mattybabaallos/ACIS/Code/ACIS/TestImages/left.jpg

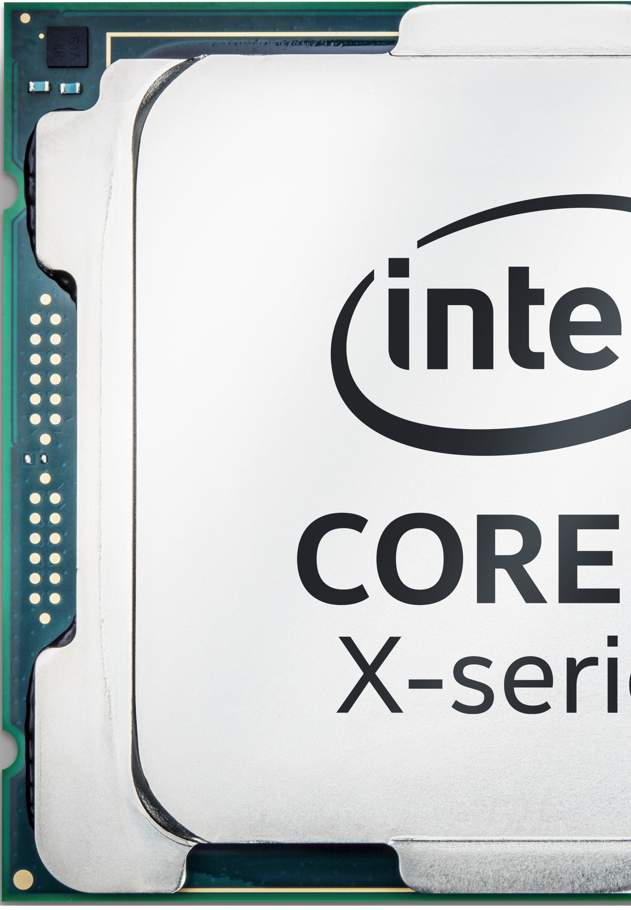
Code/ACIS/TestImages/left.jpg
