mattybabaallos/ACIS/Code/ACIS/TestImages/real1.jpg

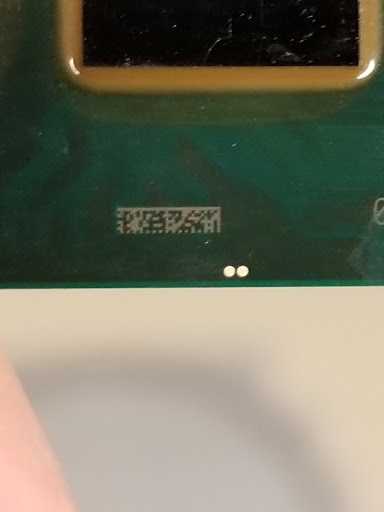
Code/ACIS/TestImages/real1.jpg
