mattybabaallos/ACIS/README.md

# ACIS
Automated Check-in Station

This repo is the home for the ACIS Portland State University ECE 2018 Capstone.
