mattybabaallos/ACIS/Documents/poster_diagram.pdf

Windows front end
Mechanical unit

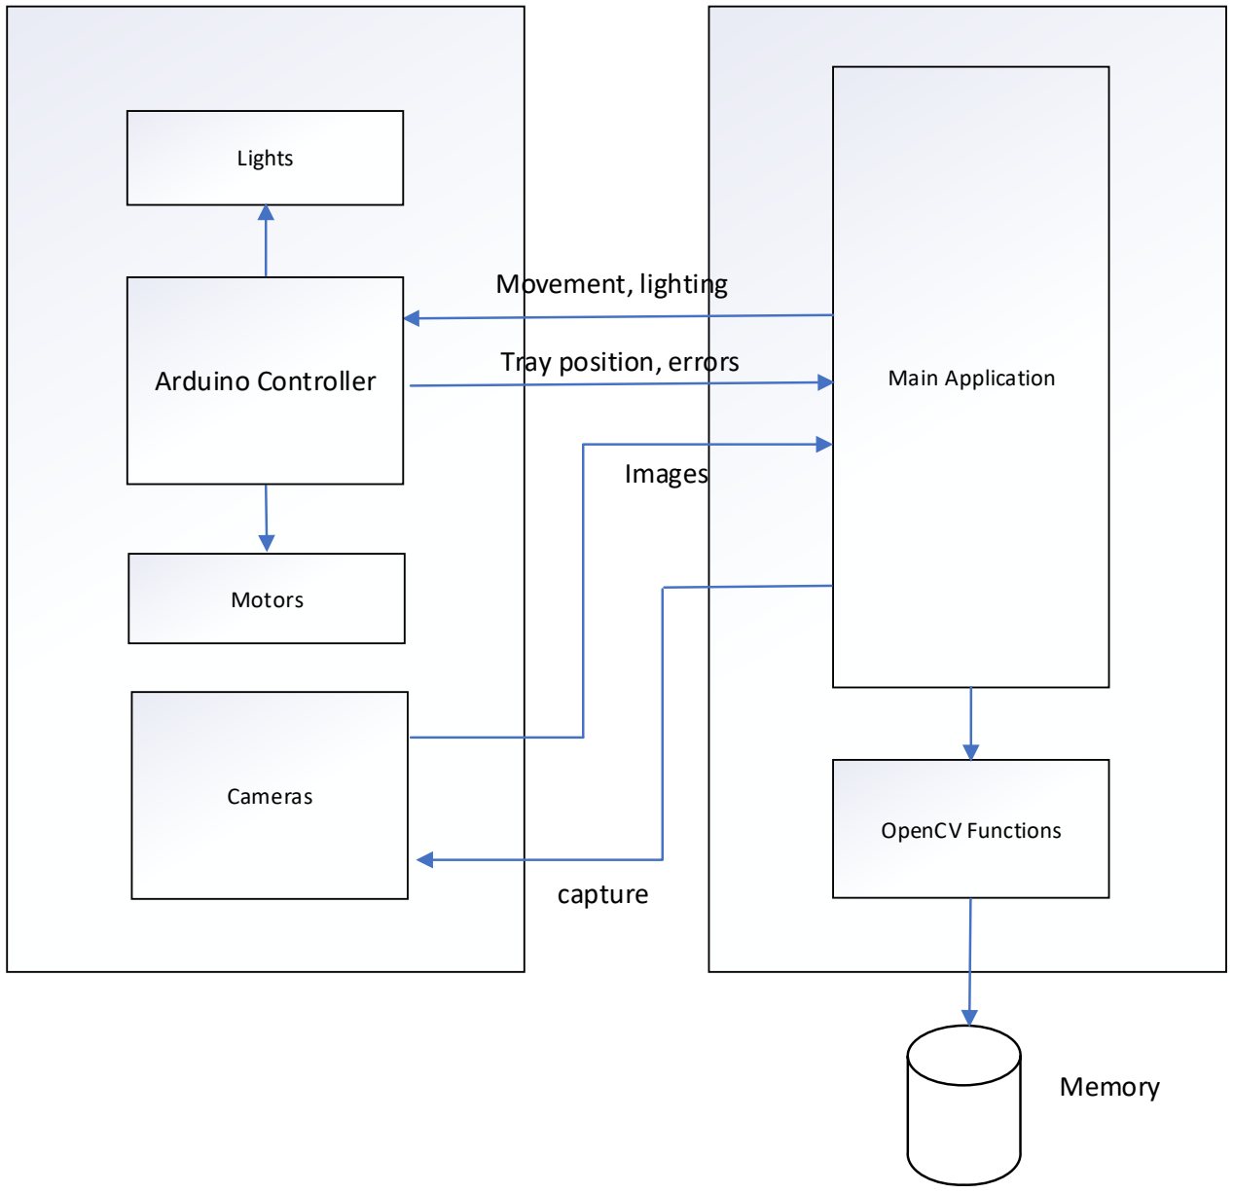
[picture p3: figure]
Main Application; OpenCV Functions; Cameras; Memory; Arduino Controller; Motors; Lights; Tray position, errors; Movement, lighting; Images; capture
