mattybabaallos/ACIS/Code/ACIS/CV/Resources/barcode3.jpg

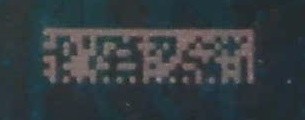
Code/ACIS/CV/Resources/barcode3.jpg
