mattybabaallos/ACIS/Code/ACIS/CV/Resources/barcode4.jpg

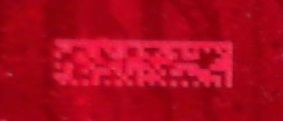
Code/ACIS/CV/Resources/barcode4.jpg
