mattybabaallos/ACIS/Code/ACIS/CV/Resources/Bot.jpg

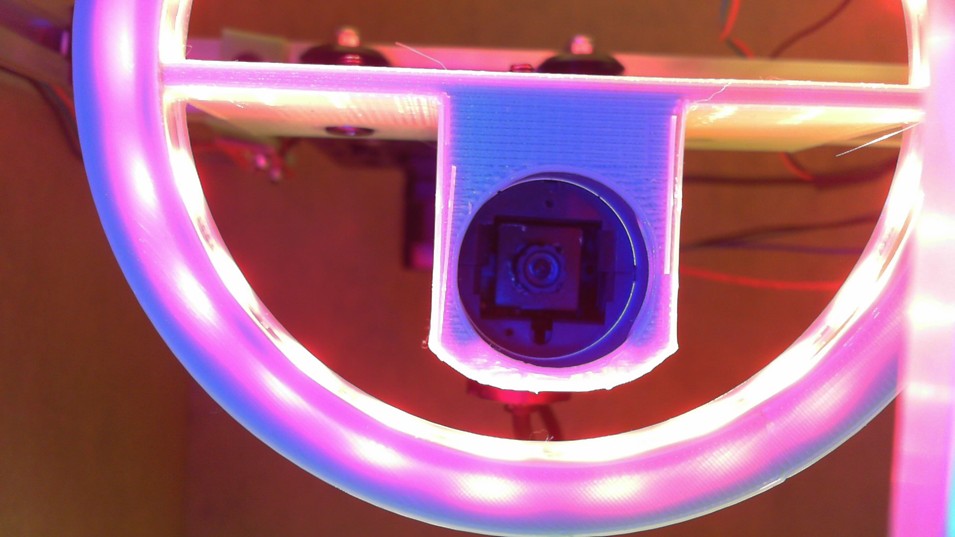
Code/ACIS/CV/Resources/Bot.jpg
