mattybabaallos/ACIS/Code/ACIS/CV/Resources/Bottom.jpg

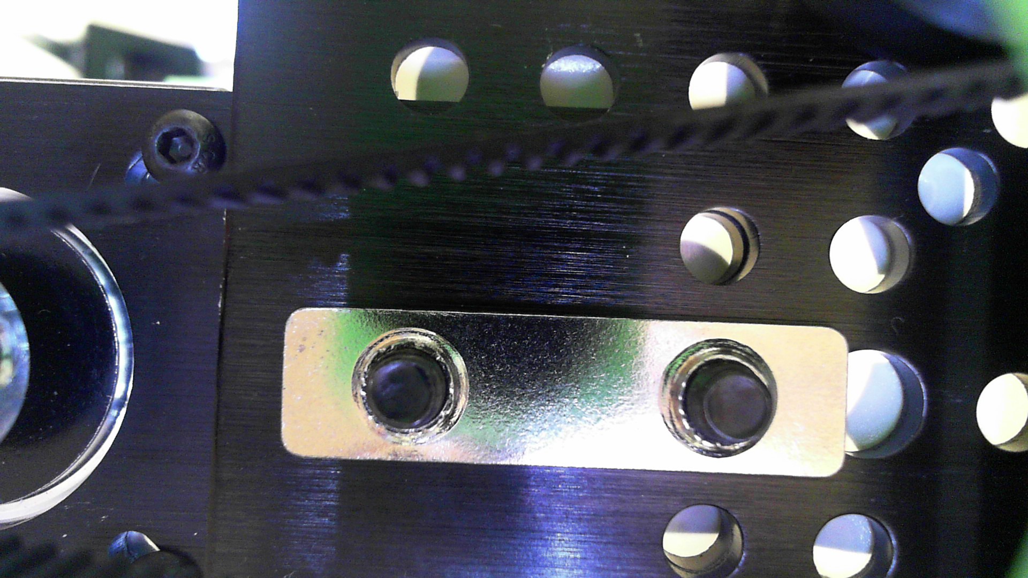
Code/ACIS/CV/Resources/Bottom.jpg
