mattybabaallos/ACIS/Code/ACIS/CV/Resources/Bottom_datamatrix.jpg

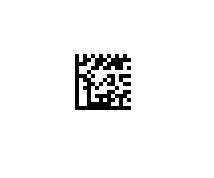
Code/ACIS/CV/Resources/Bottom_datamatrix.jpg
