mattybabaallos/ACIS/Code/ACIS/CV/Resources/Top.jpg

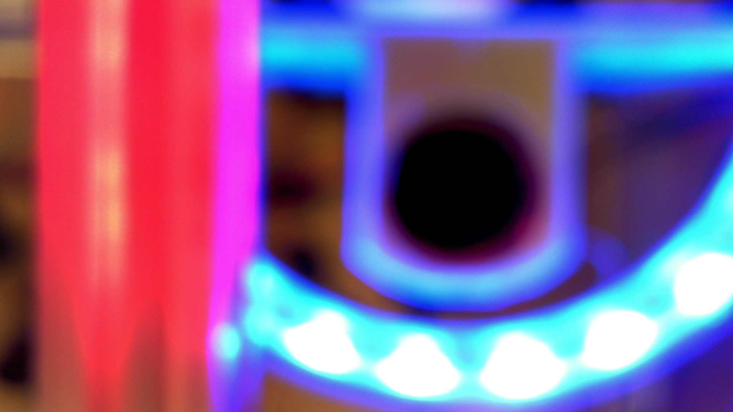
Code/ACIS/CV/Resources/Top.jpg
