mattybabaallos/ACIS/Code/ACIS/CV/Resources/Top_datamatrix.jpg

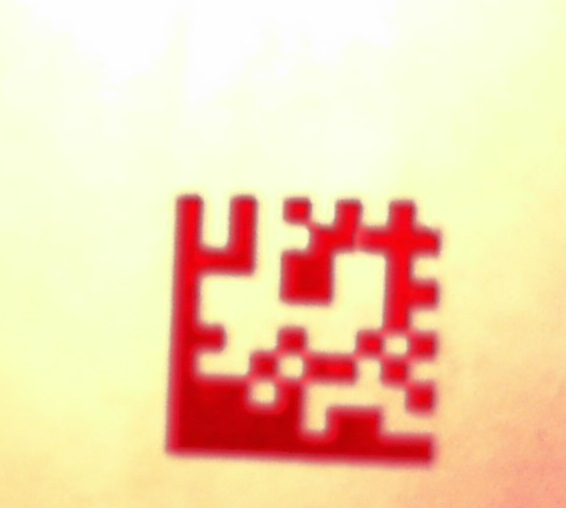
Code/ACIS/CV/Resources/Top_datamatrix.jpg
