mattybabaallos/ACIS/Documents/poster_diagram.png

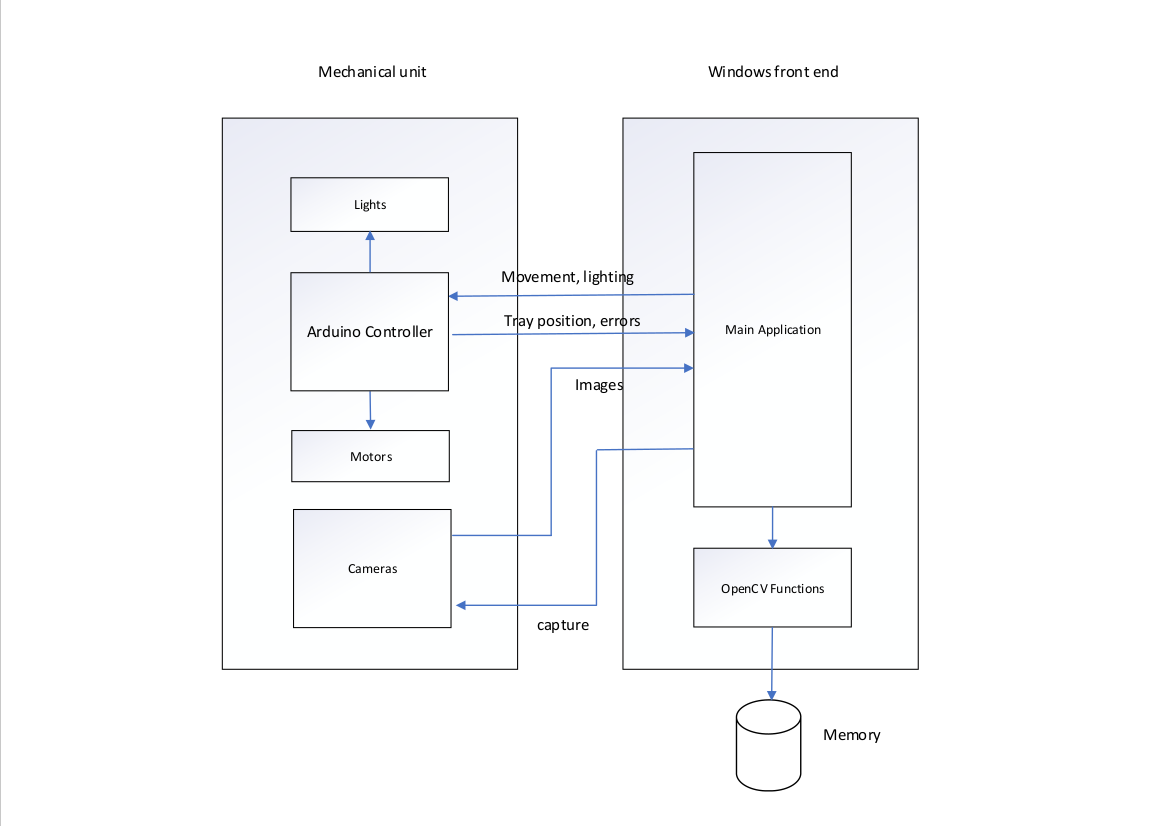
Documents/poster_diagram.png
