mattybabaallos/ACIS/Documents/3DModels/tray_assembly.SLDASM

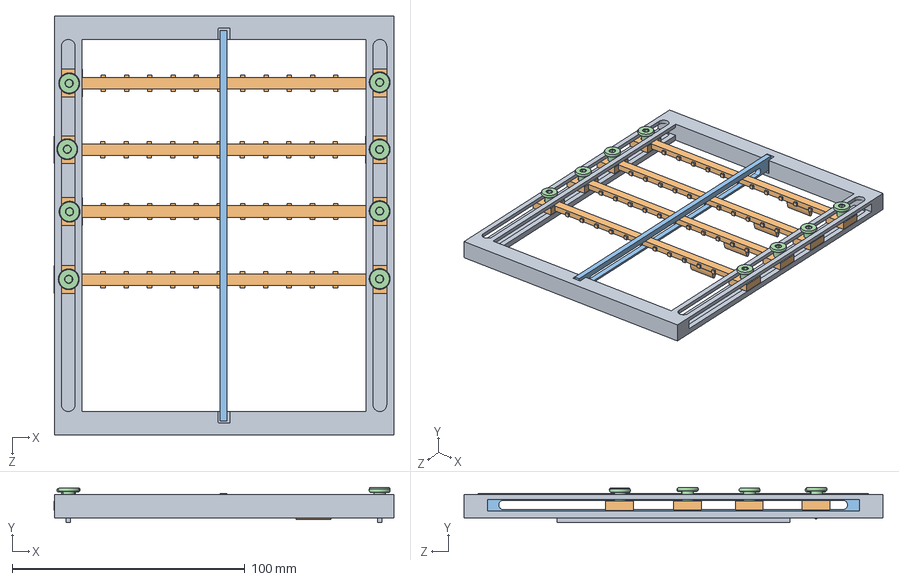
[picture p35: CAD file, 2018-04-30]
Documents/3DModels/tray_assembly.SLDASM
146.2 x 15.1 x 180.0 mm
main4
holder x 4
middlebar
Low Profile Screw M5 x 8
