mattybabaallos/ACIS/Documents/3DModels/main.STL

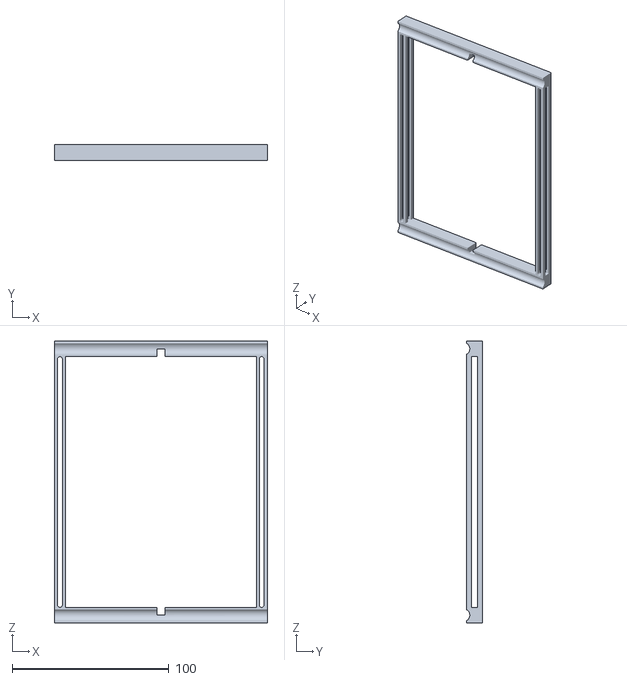
[picture p36: CAD file, 2018-04-12]
Documents/3DModels/main.STL
136.0 x 10.00 x 180.0
