mattybabaallos/ACIS/Documents/3DModels/smalltray.SLDPRT

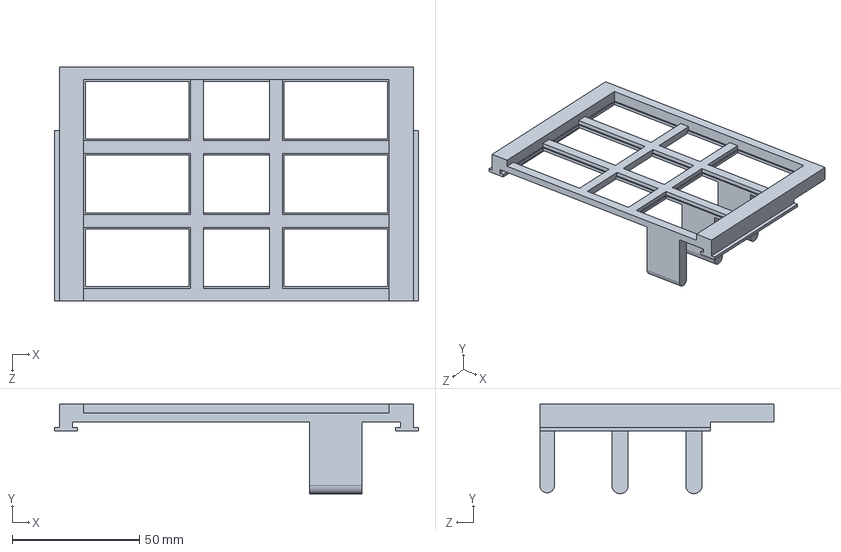
[picture p37: CAD file, 2018-04-30]
Documents/3DModels/smalltray.SLDPRT
143.0 x 35.2 x 92.0 mm
