mattybabaallos/ACIS/Documents/3DModels/STL Files/USB connector v31.stl

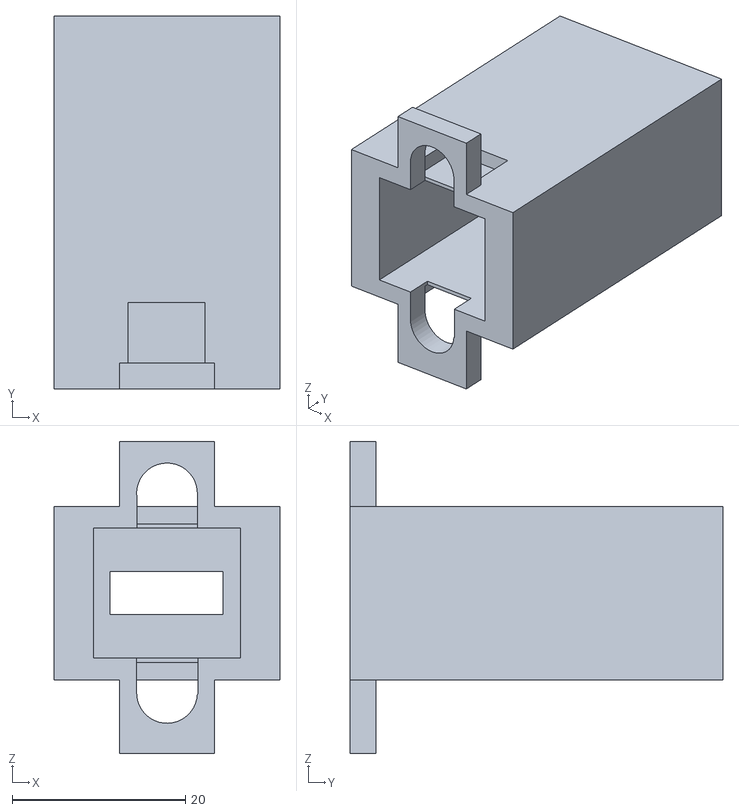
[picture p38: CAD file, 2018-06-16]
Documents/3DModels/STL Files/USB connector v31.stl
26.0 x 43.0 x 36.0
