mattybabaallos/ACIS/Documents/xdf/top 1.dxf

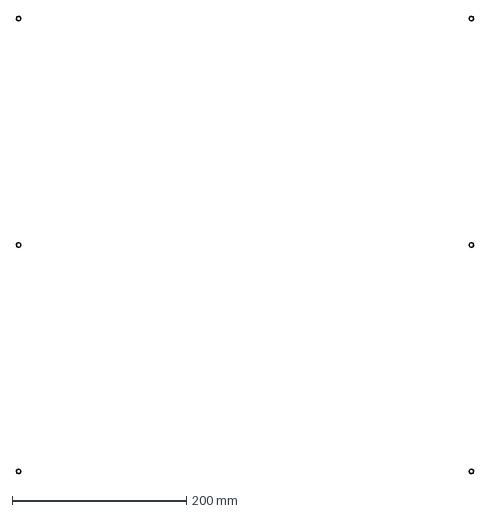
[picture p39: CAD file, 2018-05-24]
Documents/xdf/top 1.dxf
525.0 x 525.0 mm
