mattybabaallos/ACIS/Documents/3DModels/STL Files/camera lens v1.stl

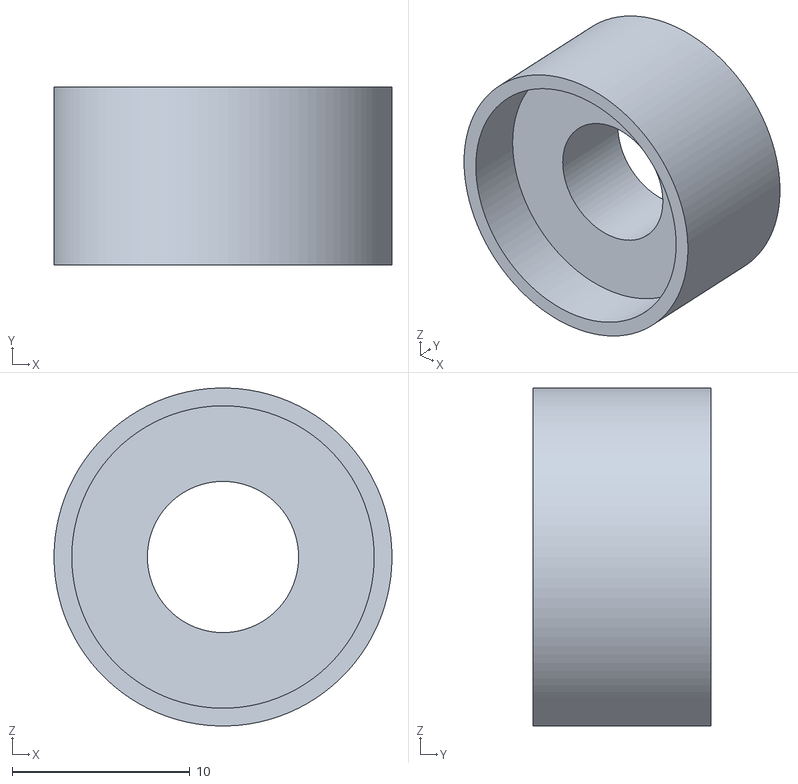
[picture p40: CAD file, 2018-06-16]
Documents/3DModels/STL Files/camera lens v1.stl
19.0 x 10.0 x 19.0
