mattybabaallos/ACIS/Documents/xdf/right.dxf

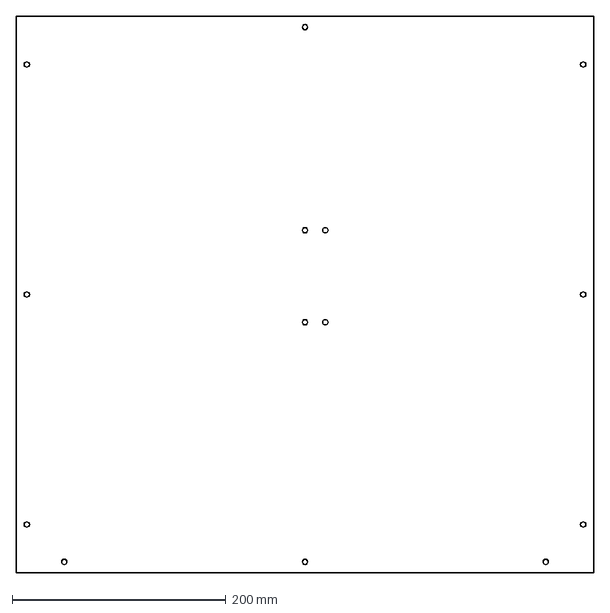
[picture p41: CAD file, 2018-05-24]
Documents/xdf/right.dxf
540.0 x 520.0 mm
