mattybabaallos/ACIS/Documents/3DModels/STL Files/Bottom camera v4.stl

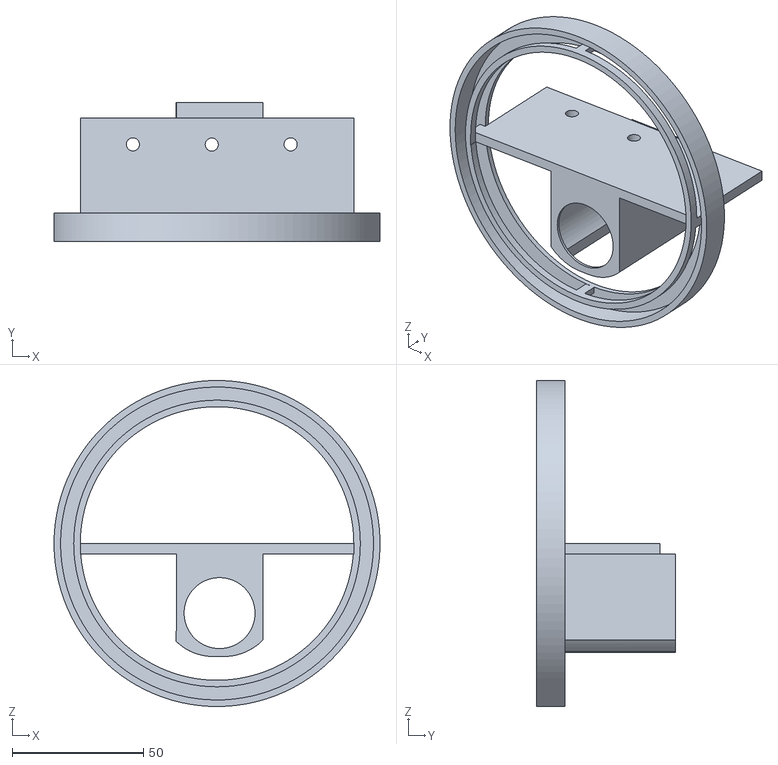
[picture p42: CAD file, 2018-06-16]
Documents/3DModels/STL Files/Bottom camera v4.stl
124.0 x 53.0 x 124.0
