mattybabaallos/ACIS/Documents/3DModels/x_button_holder.STL

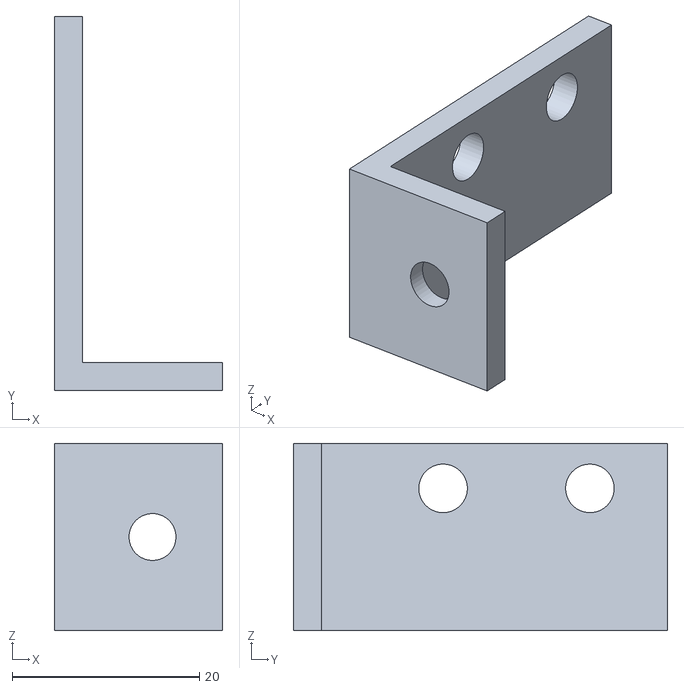
[picture p43: CAD file, 2018-04-30]
Documents/3DModels/x_button_holder.STL
18.0 x 40.0 x 20.0
