mattybabaallos/ACIS/Documents/xdf/back 2.dxf

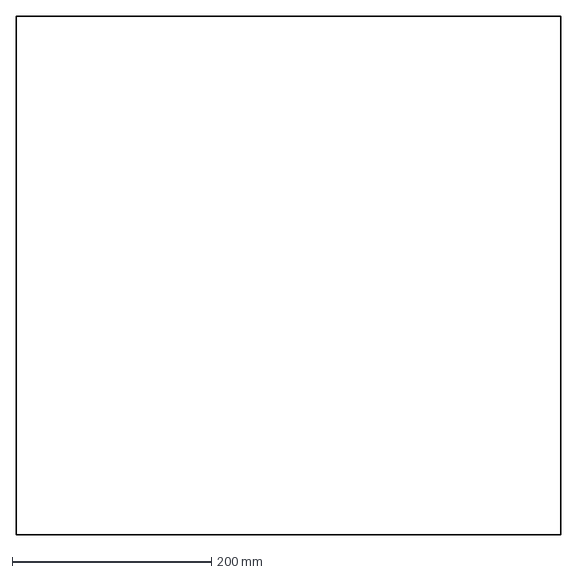
[picture p44: CAD file, 2018-05-24]
Documents/xdf/back 2.dxf
546.0 x 520.0 mm
