mattybabaallos/ACIS/Documents/3DModels/STL Files/Camera top v35.stl

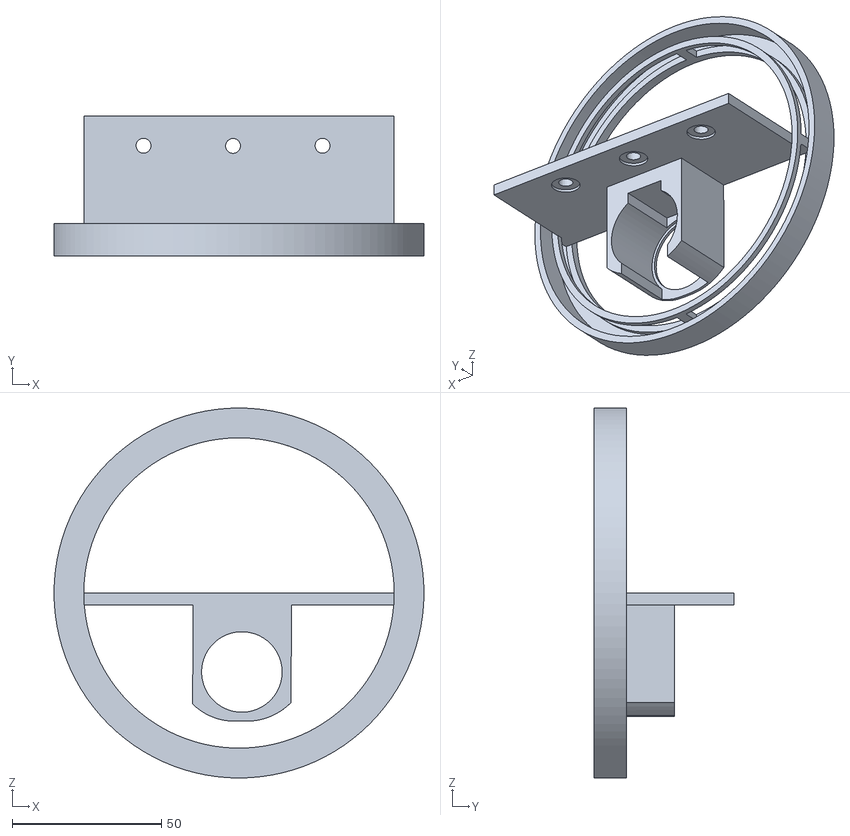
[picture p45: CAD file, 2018-06-16]
Documents/3DModels/STL Files/Camera top v35.stl
124.0 x 47.0 x 124.0
