mattybabaallos/ACIS/Documents/3DModels/x_button_top.STL

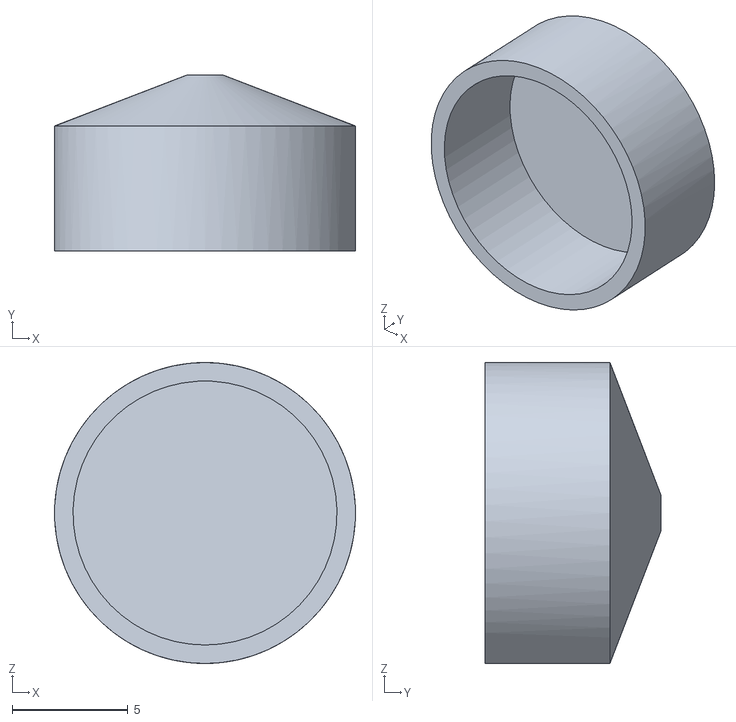
[picture p46: CAD file, 2018-04-30]
Documents/3DModels/x_button_top.STL
13.0 x 7.60 x 13.0
