mattybabaallos/ACIS/Documents/xdf/front 1.dxf

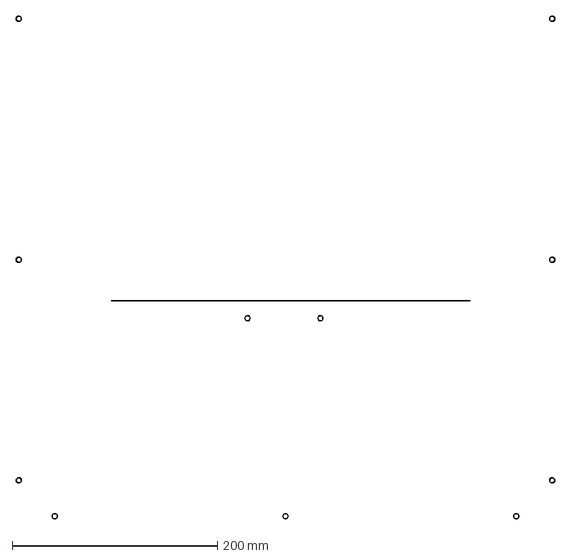
[picture p47: CAD file, 2018-05-24]
Documents/xdf/front 1.dxf
525.0 x 490.0 mm
