mattybabaallos/ACIS/Documents/3DModels/middlebar.STL

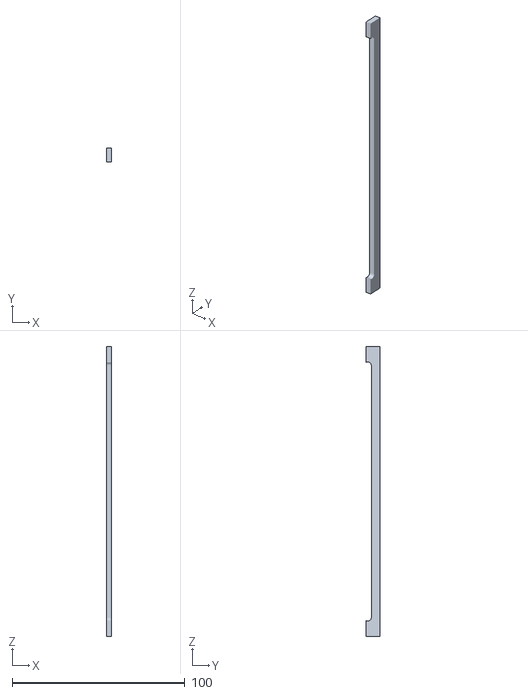
[picture p48: CAD file, 2018-04-30]
Documents/3DModels/middlebar.STL
3.00 x 8.00 x 168.0
