mattybabaallos/ACIS/Documents/3DModels/STL Files/SmallCamera holder v15.stl

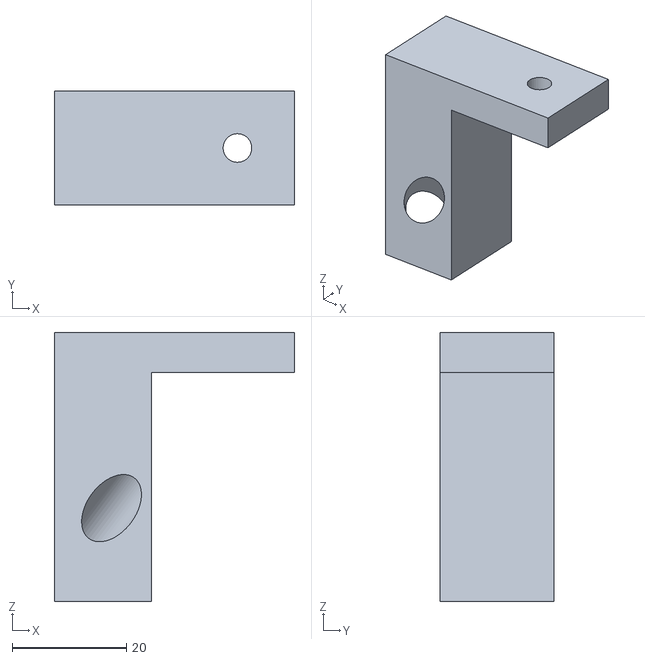
[picture p49: CAD file, 2018-06-14]
Documents/3DModels/STL Files/SmallCamera holder v15.stl
42.0 x 20.0 x 47.0
