mattybabaallos/ACIS/Documents/xdf/back 1.dxf

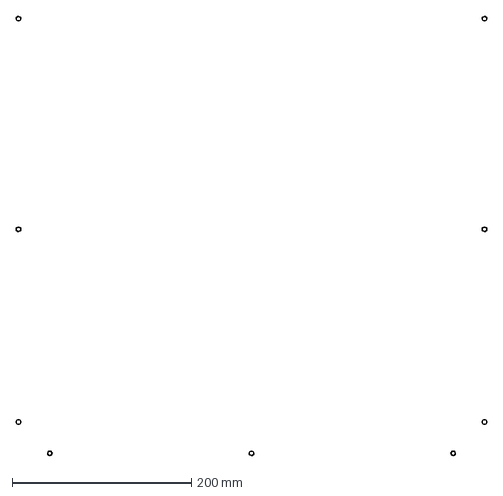
[picture p50: CAD file, 2018-05-24]
Documents/xdf/back 1.dxf
525.0 x 490.0 mm
