mattybabaallos/ACIS/Documents/3DModels/STL Files/PSU bracket_with_notch v6.stl

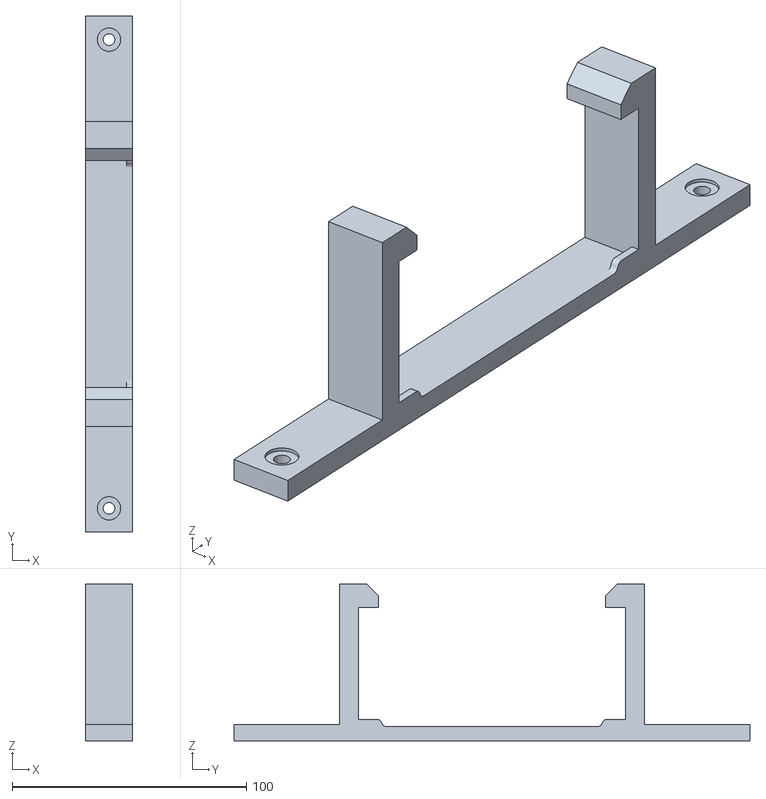
[picture p51: CAD file, 2018-05-22]
Documents/3DModels/STL Files/PSU bracket_with_notch v6.stl
20.0 x 220.0 x 67.0
