mattybabaallos/ACIS/Documents/xdf/front 2.dxf

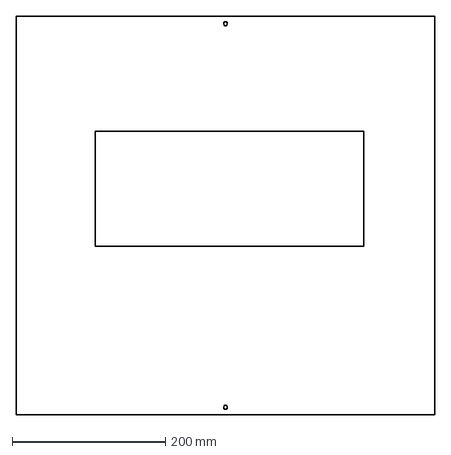
[picture p52: CAD file, 2018-05-24]
Documents/xdf/front 2.dxf
546.0 x 520.0 mm
