mattybabaallos/ACIS/Documents/3DModels/STL Files/PSU bracket_no_notch v8.stl

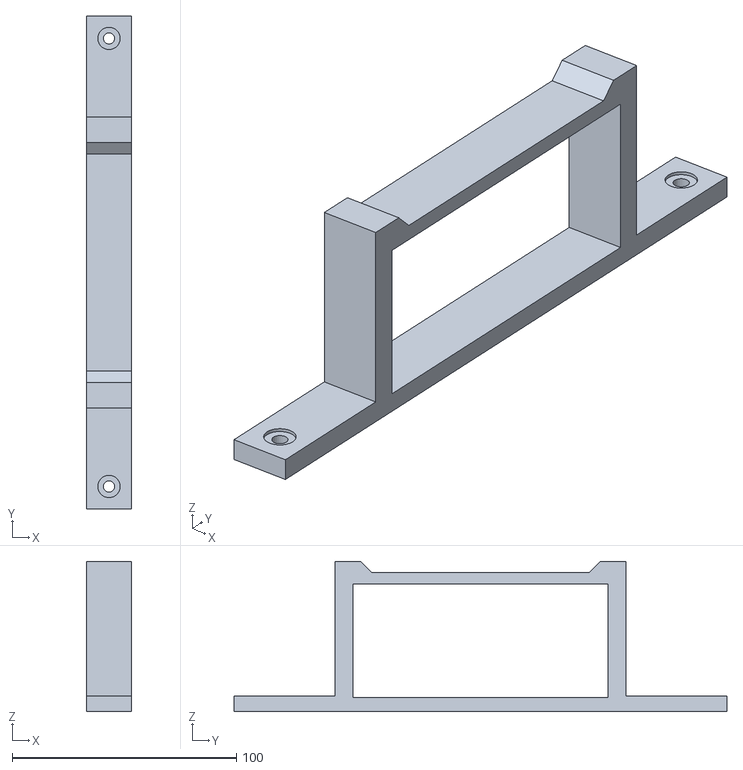
[picture p53: CAD file, 2018-05-22]
Documents/3DModels/STL Files/PSU bracket_no_notch v8.stl
20.0 x 220.0 x 67.0
