mattybabaallos/ACIS/Documents/xdf/bottom.dxf

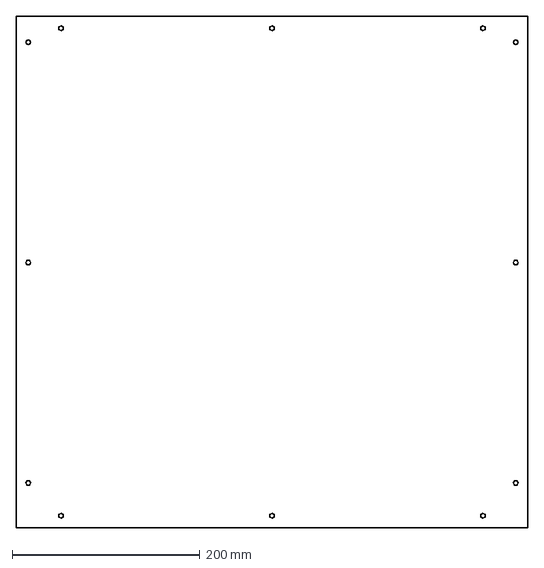
[picture p54: CAD file, 2018-05-24]
Documents/xdf/bottom.dxf
546.0 x 546.0 mm
