mattybabaallos/ACIS/Documents/3DModels/STL Files/Limit Switch v10.stl

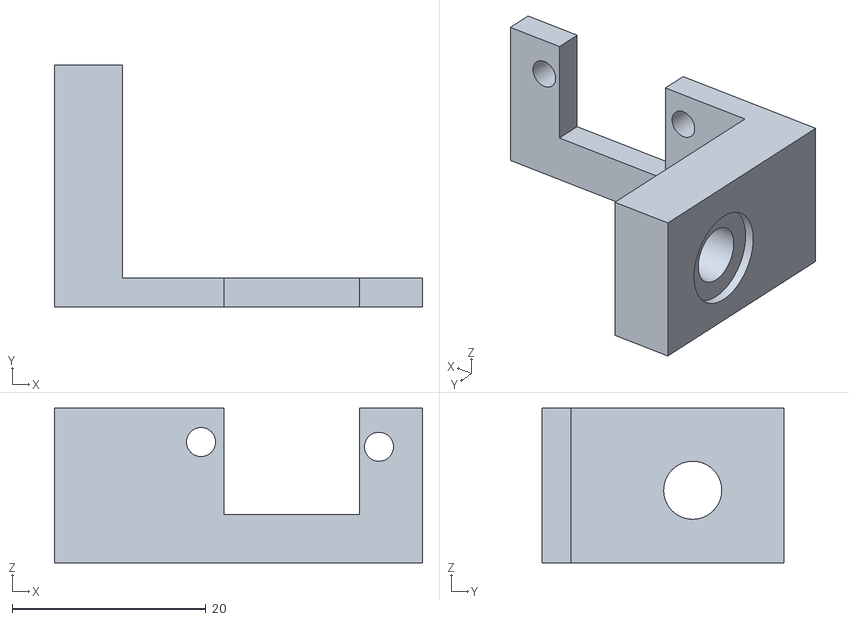
[picture p55: CAD file, 2018-05-18]
Documents/3DModels/STL Files/Limit Switch v10.stl
38.0 x 25.0 x 16.0
