mattybabaallos/ACIS/Documents/xdf/left.dxf

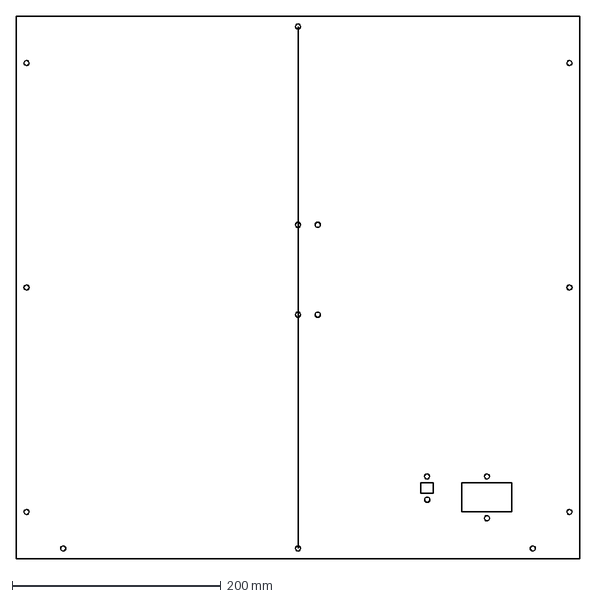
[picture p56: CAD file, 2018-05-24]
Documents/xdf/left.dxf
540.0 x 520.0 mm
