mattybabaallos/ACIS/Documents/3DModels/STL Files/Hub v28.stl

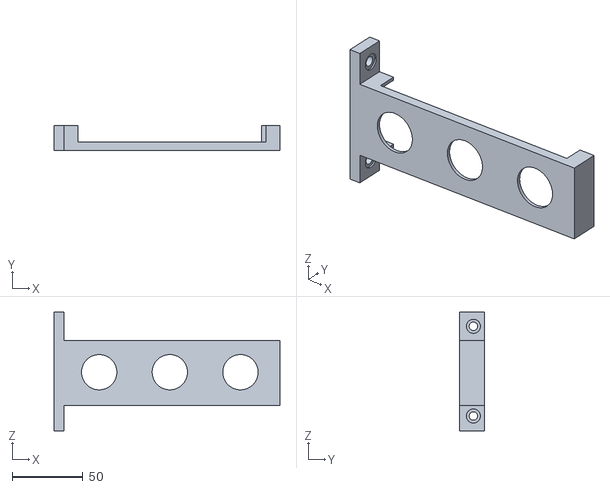
[picture p57: CAD file, 2018-05-18]
Documents/3DModels/STL Files/Hub v28.stl
160.0 x 18.0 x 84.0
