mattybabaallos/ACIS/Documents/xdf/top 2.dxf

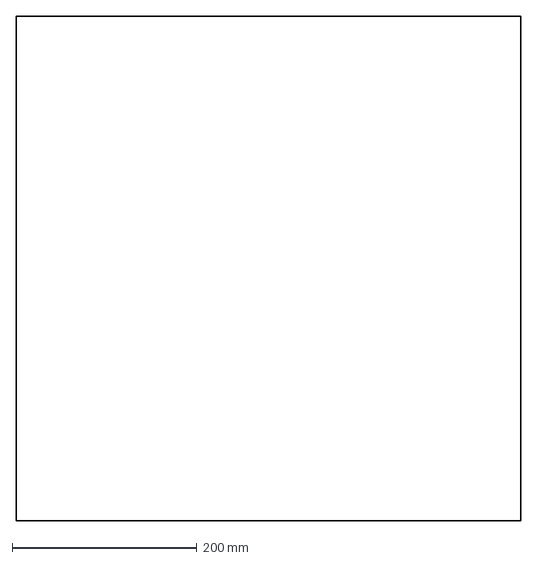
[picture p58: CAD file, 2018-05-24]
Documents/xdf/top 2.dxf
546.0 x 546.0 mm
