mattybabaallos/ACIS/Documents/3DModels/STL Files/arduino uno v23.stl

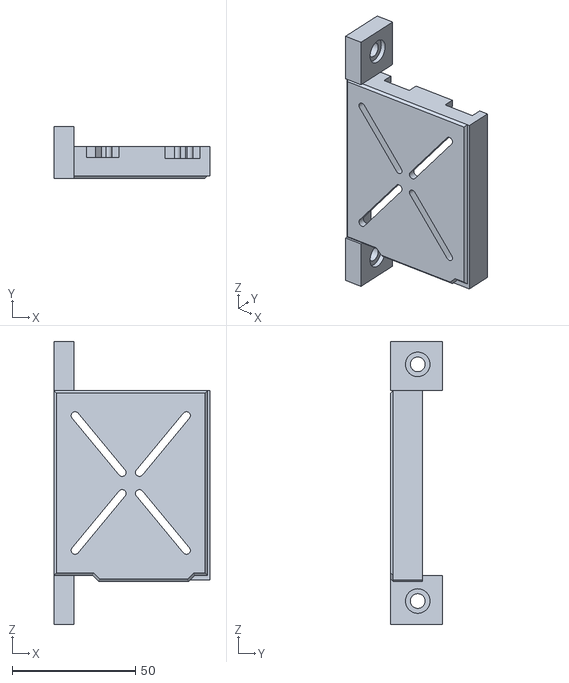
[picture p59: CAD file, 2018-05-18]
Documents/3DModels/STL Files/arduino uno v23.stl
63.3 x 21.0 x 115.0
