mattybabaallos/ACIS/(list of files, cad)

Other CAD files:
Documents/3DModels/Enclosure/Back v5.f3d
Documents/3DModels/Enclosure/Bottom v12.f3d
Documents/3DModels/Enclosure/Front v23.f3d
Documents/3DModels/Enclosure/Left v38.f3d
Documents/3DModels/Enclosure/Right v3.f3d
Documents/3DModels/Enclosure/Top v20.f3d
Documents/3DModels/Fusion 360 Files/Bottom camera v4.f3d
Documents/3DModels/Fusion 360 Files/Camera top v35.f3d
Documents/3DModels/Fusion 360 Files/Hub v28.f3d
Documents/3DModels/Fusion 360 Files/Limit Switch v10.f3d
Documents/3DModels/Fusion 360 Files/PSU bracket_no_notch v8.f3d
Documents/3DModels/Fusion 360 Files/PSU bracket_with_notch v6.f3d
Documents/3DModels/Fusion 360 Files/SmallCamera holder v15.f3d
Documents/3DModels/Fusion 360 Files/USB connector v31.f3d
Documents/3DModels/Fusion 360 Files/arduino uno v23.f3d
Documents/3DModels/Fusion 360 Files/camera lens v1.f3d
Documents/3DModels/smalltray.STL
Documents/3DModels/tray_assembly.3MF
