mattybabaallos/ACIS/Code/ACIS/TestImages/Chip_back.jpg

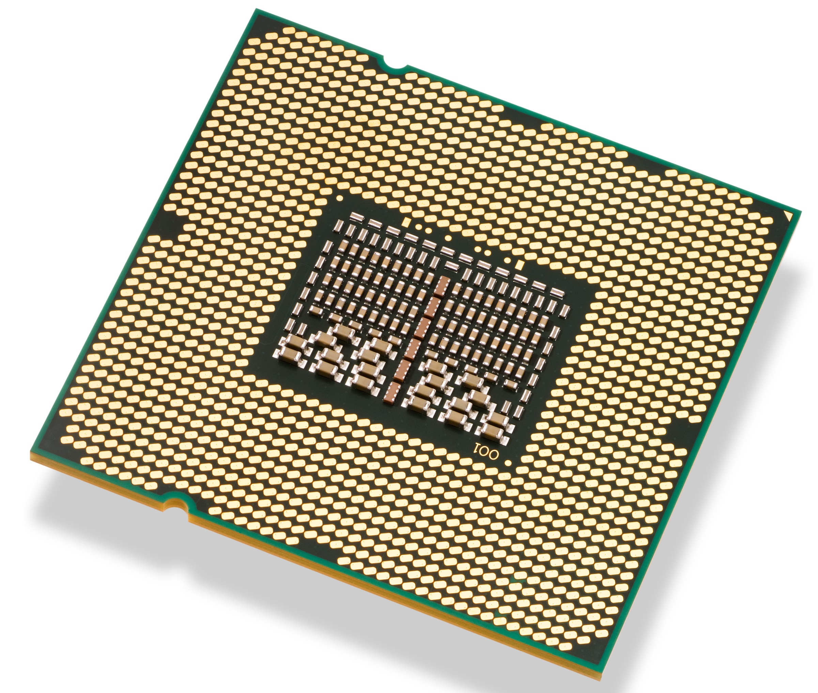
Code/ACIS/TestImages/Chip_back.jpg
