mattybabaallos/ACIS/Code/ACIS/TestImages/Chip_front_HR.jpg

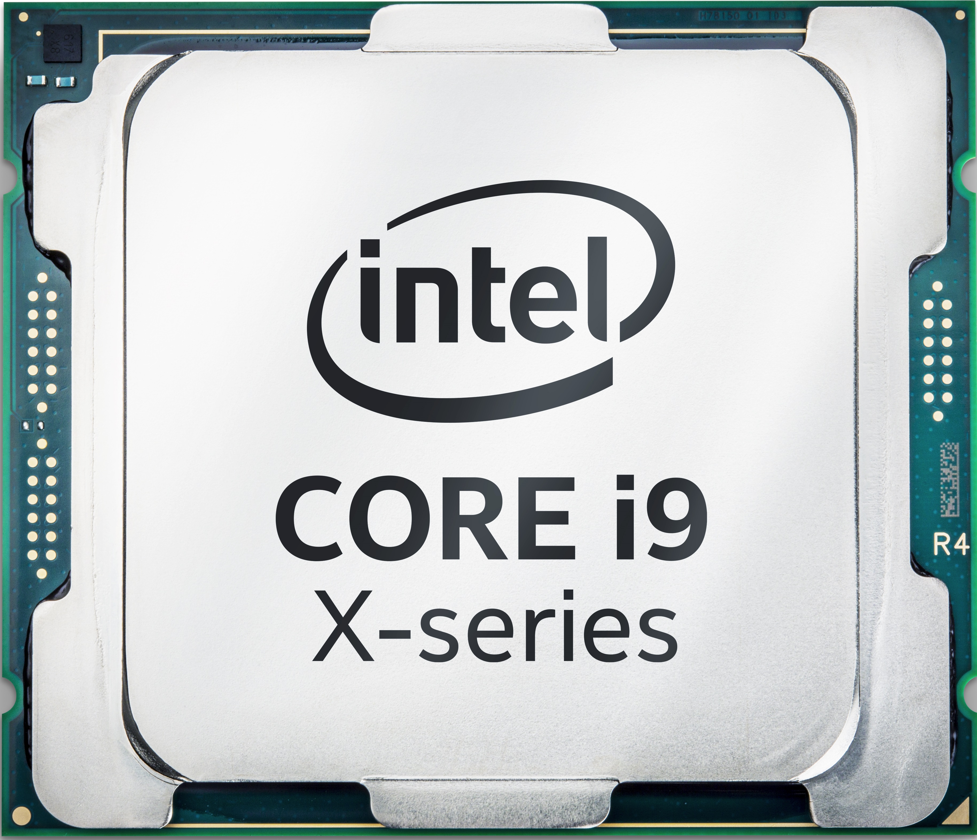
Code/ACIS/TestImages/Chip_front_HR.jpg
