mattybabaallos/ACIS/Code/ACIS/TestImages/new_image.jpg

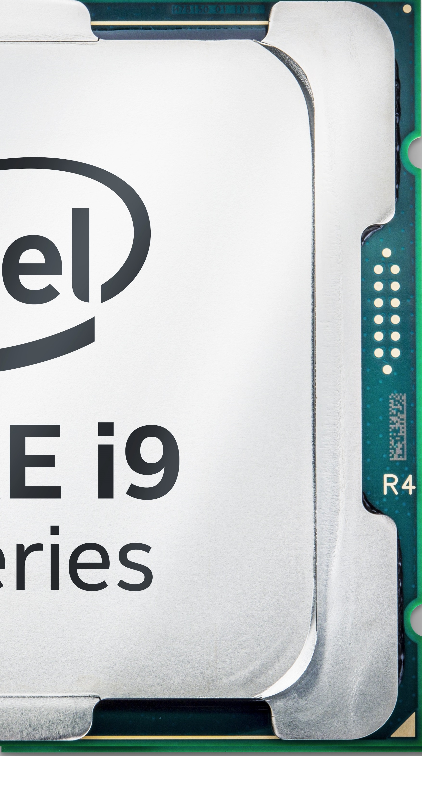
Code/ACIS/TestImages/new_image.jpg
