mattybabaallos/ACIS/Code/ACIS/TestImages/real2.PNG

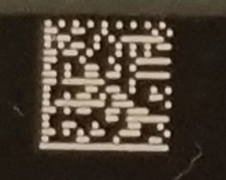
Code/ACIS/TestImages/real2.PNG
