mattybabaallos/ACIS/Code/ACIS/TestImages/real.jpg

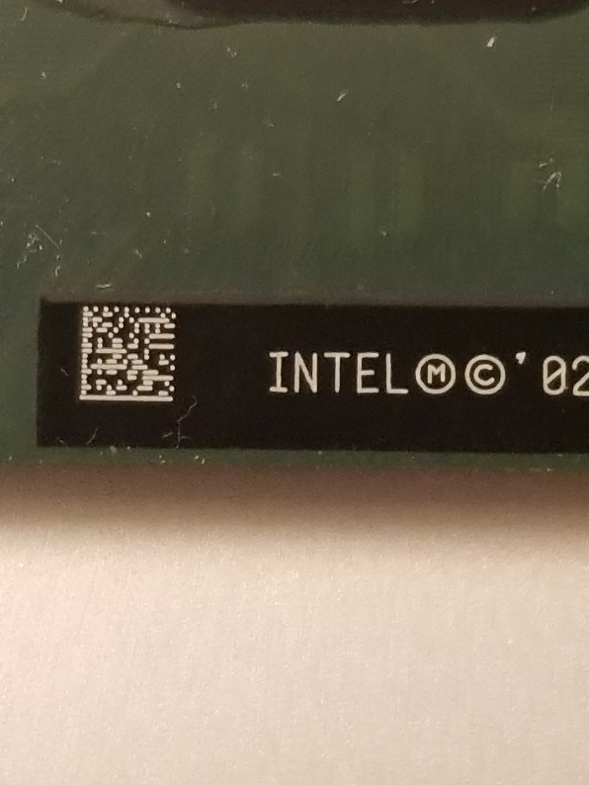
Code/ACIS/TestImages/real.jpg
