mattybabaallos/ACIS/Documents/block_diagram.pdf

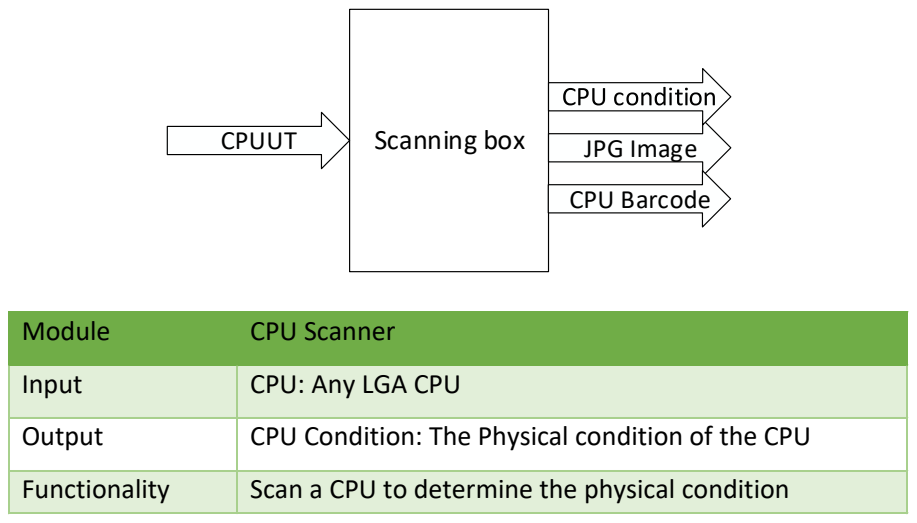
[picture p65: page 1]
Scanning box; JPG Image CPUUT; CPU Barcode; Module; CPU Scanner

Input | CPU: Any LGA CPU
Output | CPU Condition: The Physical condition of the CPU
Functionality | Scan a CPU to determine the physical condition

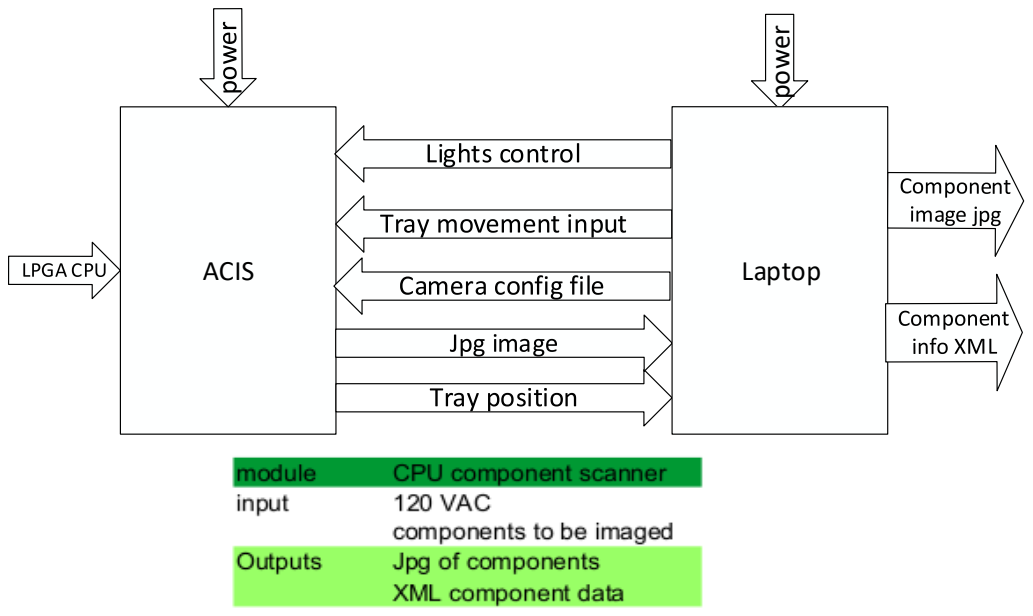
[picture p66: page 2]
ACIS; power; Laptop

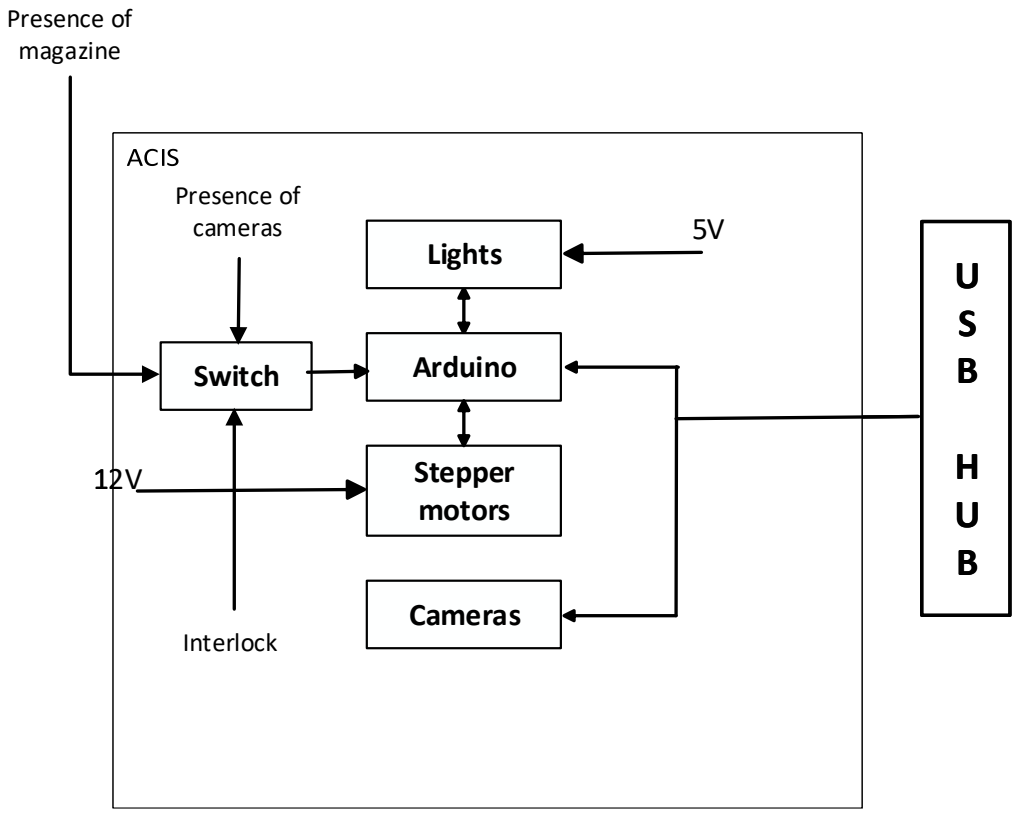
[picture p67: page 3]
Switch; Cameras; Stepper motors; Arduino; Lights; B HUB; Interlock; Presence of magazine; Presence of; cameras

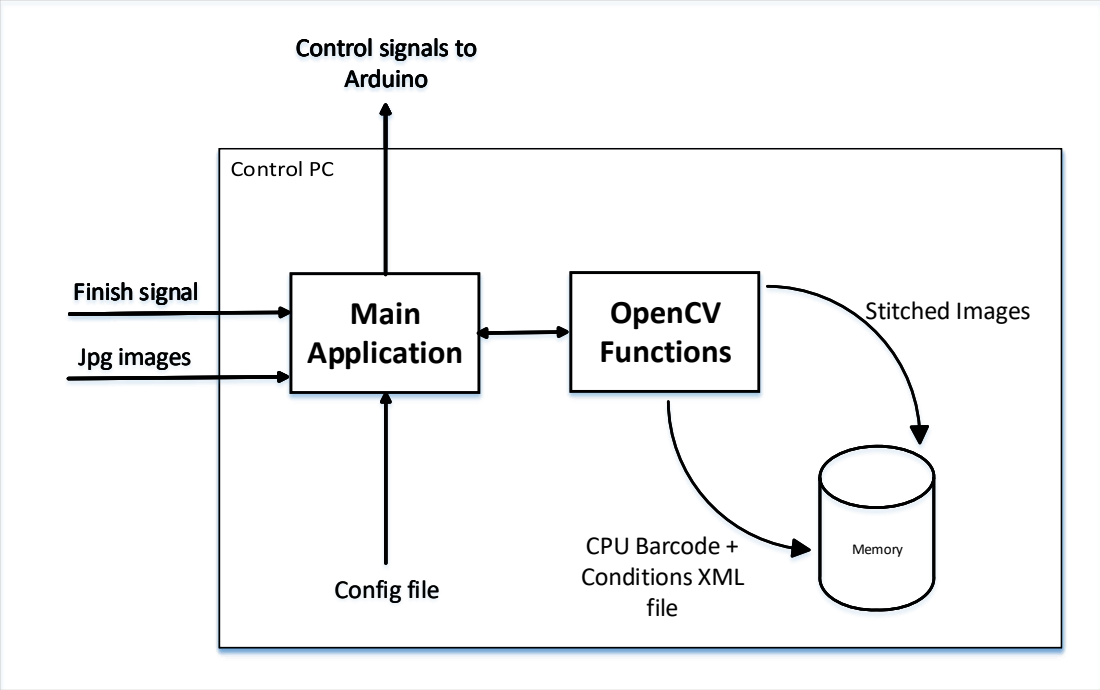
[picture p68: page 4]
Main Application; Config file; OpenCV Functions; Finish signal; CPU Barcode + Conditions XML file; Stitched Images; Memory; Jpg images

Control signals to
Arduino

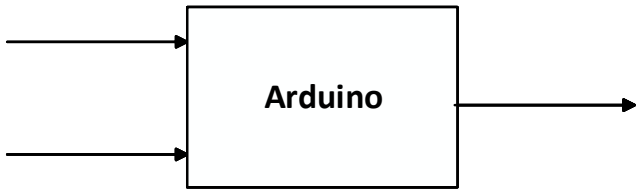
[picture p69: figure]
Arduino

5V

### Control signals Switches

Module | Arduino Controller
Input | 5V Switch position
Output | Control signals
Functionality | Send PWM signals to stepper motors, lights to start the scanning process based on the control signals from main application (which based on a config file) as the magazine inserted

Module | Illumination control
Input | 5V Stream of bits from Arduino
Output | Lights’ brightness and color
Functionality | Take PWM signal from Arduino as input to provide light emission

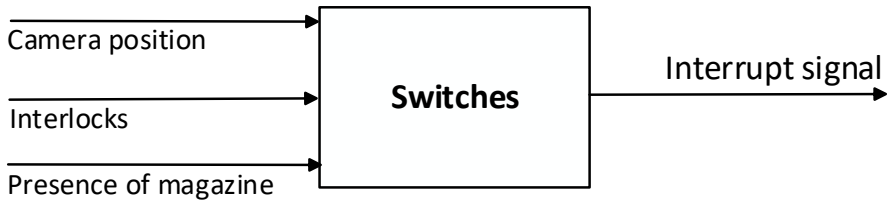
[picture p70: figure]
Switches; Camera position; Presence of magazine; Interrupt signal; Interlocks

Module | Switch sensing magazine
Input | 5V Magazine Camera position Interlocks
Output | Interrupt signal (1 or 0)
Functionality | Send an interrupt signal to Arduino as the magazine inserted to start the scanning process

### Stepper motors

12V

Control
Signals

### Motion

Module | Stepper motors motion
Input | 5V Control Signals
Output | Stepper motors motion
Functionality | Take control signals from Arduino to start rotating stepper motors
