mattybabaallos/ACIS/(commit log)

2018-02-24 Added Arduino skeleton code + basic motor control
2018-03-30 initialized boards and motors plus #defines
2018-03-30 motor class implmentation progress
2018-04-03 arduino code compiles
2018-04-03 Added testing framework for c++ code
2018-04-04 Converted code to statically alloacted to avoid memory leak
    [acis.cpp, acis.h, acis.ino, common.h, main.cpp, motor.cpp, motor.h, test.h]
2018-04-04 test framework
2018-04-05 added limit switch class
2018-04-05 Added interrupt handlers for 3 switches
2018-04-05 Added the remaining interrupts handlers
2018-04-11 C# code now gets data from arduino
2018-04-12 stl files for outline of tray
    [main.STL, middlebar.STL]
2018-04-12 Merged tray 3D models
    [main.STL, middlebar.STL]
2018-04-13 changed for printability and new main part design
    [middlebar.STL]
2018-04-14 error messages update the UI
    [acis.ino]
2018-04-17 Changed Arduino to send back if interrupts happens
2018-04-19 End stop 3D model
    [Cobblebot_end_stop_holder v3 v1.f3d, End stop.stl]
2018-04-20 updated consts to match the device
2018-04-20 ICommand for buttons
2018-04-20 Added home commands will be sent to Arduino
2018-04-20 using motor enums
2018-04-20 new holder designs
    [main4.SLDPRT, main4.STL]
2018-04-20 new width middlebar
    [middlebar.STL]
2018-04-21 completed all holder parts and generated gcode
    [Part1.SLDPRT, holder.SLDPRT, holder.STL, middlebar.SLDPRT]
2018-04-21 added trigger bump to holder piece
    [holder.SLDPRT, holder.STL]
2018-04-21 added assembly files
    [tray_assembly.3MF, tray_assembly.SLDASM]
2018-04-21 new assembly
    [tray_assembly.3MF, tray_assembly.SLDASM]
2018-04-21 added printing file
2018-04-21 added holes to main for insertion of holder. added screws to assem.
    [main4.SLDPRT, tray_assembly.SLDASM]
2018-04-21 This one has insertion holes
    [main4.STL]
2018-04-22 changed gcode to avoid dead spot on printer
2018-04-22 reduced actuator bump to 2.5 radius half-circle
    [holder.SLDPRT, holder.STL]
2018-04-23 altered main slot to fit holder with screw heads
    [main4.SLDPRT, main4.STL]
2018-04-23 Added frame
2018-04-24 Fixed some bugs with arduino code
    [acis.cpp, acis.ino, common.h, motor.cpp, motor.h]
2018-04-24 Thread sync and cancelable scan
2018-04-24 Merged Thao's brows button code
2018-04-24 holder redesign
    [holder.SLDPRT, holder.STL, main5.SLDPRT, main5.STL, middlebar.SLDPRT, middlebar.STL]
2018-04-26 Pin change based interrupts
2018-04-26 external interrupt overload. new models
    [Black Angle Corner Connector_spacer.STL, smalltray.SLDPRT, smalltray.STL, x_button_top.STL]
2018-04-27 x_button models
    [Black Angle Corner Connector_spacer.STL, Part1.SLDPRT, holder.SLDPRT, holder.STL, main4.SLDPRT, main4.STL, main5.SLDPRT, main5.STL]
2018-04-30 Fixed bug
    Fixed bug where the value sent is being used as signed byte #103
    [acis.cpp, acis.h, acis.ino, motor.cpp, motor.h]
2018-04-30 enabled bottom motor
2018-05-03 Tray axis switch enabled
2018-05-04 Enable/Disbale Start/Stop scan buttons
2018-05-05 Y axis cpu switch
2018-05-10 imported leds code
2018-05-11 Refactor Arduino code to match new interface 1/2
2018-05-11 still updating arduino code
2018-05-14 Removed Z axis and renamed according to the naming convention
2018-05-14 Lot of progress towards LEDs code and refactoring
2018-05-15 Enable/Disbale Start/Stop Scan button
2018-05-16 Device settings style. Removed old xml file
2018-05-17 More settings and 3 models
    [Hub v26.stl, arduino uno.stl, bracket_no_notch v4.stl, bracket_with_notch v2.stl]
2018-05-17 updated hub frame
    [Hub v26.stl]
2018-05-18 More settings, tweaks to Arduino code, added button to load the tray
2018-05-18 Power supply bracket gcode
    [End stop.stl]
2018-05-18 Started adding logging framework
2018-05-18 Fixed buttons
2018-05-18 Mainly changes to camera
2018-05-22 Auto stash before merge of "master" and "origin/master"
    [bracket_no_notch v8.stl]
2018-05-22 gcode power supply
2018-05-23 gcode and stls
    [Camera v12.stl, Camera v25.stl]
2018-05-24 xdf files
    [back 1.dxf, back 2.dxf, bottom.dxf, front 1.dxf, front 2.dxf, left.dxf, right.dxf, top 1.dxf]
2018-05-25 LEDS are working now
2018-05-26 Send led commands, validating, put logging
2018-05-30 limit stl
    [Untitled(1) v10.stl]
2018-05-30 usb connector gcode
2018-06-02 remove no longer needed gcode files
    [Camera v12.stl, bracket_no_notch v4.stl, bracket_with_notch v2.stl, x_button_holder.SLDPRT, x_limitsw_holder.SLDPRT]
2018-06-02 added enclosure files
    [Back v2.f3d, Bottom v12.f3d, Front v21.f3d, Left v38.f3d, Right v3.f3d, Top v17.f3d]
2018-06-06 Two cameras implemented
2018-06-06 Added try open/close buttons and open try once the scan is done.
2018-06-06 Added a button to open the save folder location
2018-06-06 Camera changes
2018-06-07 Camera capture working
2018-06-07 Now detects Barcode Top and Barcode Bottom to determine camera index
2018-06-08 new camera holder gcode
2018-06-08 small camera gcode
2018-06-08 camera bottom gcode
2018-06-13 small camera v14
2018-06-14 cameras working. Finding camera index based on TM
2018-06-14 working camera
2018-06-15 Power supply wiring
2018-06-16 latest 3D models
    [Back v2.f3d, Back v5.f3d, Bottom camera v4.f3d, Bottom camera v4.stl, Bottom v12.f3d, Camera top v35.f3d, Camera top v35.stl, Camera v25.stl]
